Ely-S/Cerebro/spec.txt

Technical Design Document
Cerebral Oximeter
Single-Channel NIRS Relative Oxygenation Monitor
Revision 3.2 - POTS Demonstration System (Prototype 1 Robustness Update)
Course: EE 201 - Biomedical Instrumentation
Application: POTS/Orthostatic Intolerance Demonstration
Precision Target: +/- 2% (Relative Trend)
Safety Criterion: <10mW time-avg emitted power per channel (bench-verified)

-- 1 of 13 --

1. Project Overview
1.1 Objective
Design and build a biomedical device capable of detecting relative changes in cerebral oxygenation through the
human forehead using near-infrared spectroscopy (NIRS). The device is specifically optimized for
demonstrating Postural Orthostatic Tachycardia Syndrome (POTS) and orthostatic intolerance to students.
1.2 Clinical Background
POTS is characterized by an excessive heart rate increase (30+ bpm) within 10 minutes of standing. Clinical
studies show POTS patients experience cerebral oxygen saturation decreases of 5-15% during standing,
compared to only 1-3% in healthy controls. This device enables visualization of these differences for education.
1.3 Project Estimates
Category Time Notes
Probe Assembly 2-3 Hours Including headband fabrication
Circuit Wiring 3-4 Hours Include shielding
Coding & Testing 4-5 Hours Enhanced signal processing
Total Build Time 10-14 Hours Allow extra for troubleshooting
Component Cost: $55-92 USD per station (carrier boards removed per DCN-001)
DCN-002 (2026-03-03): TIA compensation capacitor updated from 4.7pF to 10pF
for robustness. This increases estimated phase margin from ~47deg to ~60deg
against breadboard stray capacitance; not a functional failure correction.

-- 2 of 13 --

2. Design Overview
2.1 How It Works - Simple Explanation
This device measures how much oxygen is in the blood flowing through your brain. It works by shining special
near-infrared light through your forehead and measuring how much light comes back out. Here is the key
principle:
The Basic Idea:
1. Two LEDs shine near-infrared light (730nm and 850nm) into your forehead
2. This light passes through skin, skull, and reaches brain tissue
3. Oxygen-rich blood absorbs different amounts of light than oxygen-poor blood
4. A photodiode detects the light that bounces back
5. By comparing the two wavelengths, we can track oxygenation changes
Think of it like shining a flashlight through your hand in a dark room - you can see the red glow because red
light passes through tissue. Near-infrared light works similarly but penetrates deeper, reaching the brain. Blood
with more oxygen absorbs more infrared light at certain wavelengths, so by measuring how much light is
absorbed, we can track whether brain oxygenation is going up or down.
2.2 Why Two Wavelengths?
We use two different colors of infrared light because oxygenated hemoglobin (HbO2) and deoxygenated
hemoglobin (Hb) absorb light differently at each wavelength:
730nm (Far-Red): More sensitive to deoxygenated blood (Hb)
850nm (Infrared): More sensitive to oxygenated blood (HbO2)
By measuring both, we can track the balance between oxygen delivery and oxygen consumption in brain tissue.
2.3 What the Device Measures
This device measures relative changes from a baseline, not absolute values. It tells you whether oxygenation is
increasing or decreasing compared to when you started measuring. For POTS demonstration:
- When a healthy person stands up, oxygenation may drop 1-3% and quickly recover
- When a POTS patient stands up, oxygenation may drop 5-15% and stay low
- This difference is large enough to clearly see on a real-time graph
2.4 System Block Diagram
+------------------+
| ARDUINO |
| Nano 33 IoT |
| | +------------------+ +------------------+
| D2,D3: LED Ctrl |---->| LED DRIVER |---->| 730nm LED |---+
| | | (TIP31C x2) | | 850nm LED |---|-+
| A4,A5: I2C |<----| | +------------------+ | |
| | +------------------+ | |
| Serial Output | ^ | |
+------------------+ | Light through | |
| | forehead tissue | |
| v | |
| +------------------+ | |
| | PHOTODIODE |<----------------------------+ |
| | (BPW34) |<------------------------------+
| +------------------+

-- 3 of 13 --

| |
| | Tiny electrical current (nano-amps)
| v
| +------------------+
| | AMPLIFIER |
| | (MCP6022) |
| | 2-stage TIA |
| +------------------+
| |
| | Voltage signal (0-3V)
| v
| +------------------+
+------------->| ADC |
| (ADS1115) |
| 16-bit, 64 SPS |
+------------------+
2.5 Complete Wiring Diagram (ASCII)
================================================================================
COMPLETE WIRING DIAGRAM
================================================================================
USB Battery Pack (>=1A, always-on capable)
   |
Arduino USB port (Nano 33 IoT)
   |
  Arduino 5V pin ----> [FUSE 500mA] ----+--> [68R] --> 730nm LED (wire-pigtail, anode->cathode) --> TIP31C Q1 collector
   |                                     |                                                        TIP31C Q1 emitter --> LED_GND_RETURN --> STAR_GND
   |                                     |                                                        D2 --> [470R] --> Q1 base
   |                                     |
   |                                     +--> [68R] --> 850nm LED (wire-pigtail, anode->cathode) --> TIP31C Q2 collector
   |                                                                                                 TIP31C Q2 emitter --> LED_GND_RETURN --> STAR_GND
   |                                                                                                 D3 --> [470R] --> Q2 base
   |
   +--> [150R] --> Green LED --> STAR_GND  (power-on indicator, ~20mA hold load)

Arduino Nano 33 IoT (3.3V logic)
  3.3V ----------------------------------------------+-------------------+
  GND  ---------------------------------------------------------------> STAR_GND
  A4 (SDA) -------------------------------------------> ADS1115 SDA
  A5 (SCL) -------------------------------------------> ADS1115 SCL

ADS1115 ADC
  VDD <-----------------------------------------------+ (3.3V)
  GND <---------------------------------------------------------------- STAR_GND (star node location)
  ADDR ------------------------------------------------> STAR_GND (0x48)
  A0  <----------------------------------------------- MCP6022 OUT2 (Pin 7)

Photodiode + Analog Front End (MCP6022)
  BPW34 cathode --------------------------------------> MCP6022 IN1- (Pin 2)
  BPW34 anode ----------------------------------------> STAR_GND

  Stage 1 TIA:
    Rf = 100k between OUT1 (Pin 1) and IN1- (Pin 2)
    Cf = 10pF in parallel with Rf
    IN1+ (Pin 3) -> STAR_GND
    V+  (Pin 8)  -> 3.3V
    V-  (Pin 4)  -> STAR_GND

  Stage 2 Gain (same MCP6022):
    IN2+ (Pin 5) <- Stage1 OUT (Pin 1)
    IN2- (Pin 6) <- node between Rg=1k to GND and Rf2=47k to OUT2
    OUT2 (Pin 7) -> ADS1115 A0

Decoupling / layout notes:
  - 0.1uF local decoupling at MCP6022 and ADS1115 power pins
  - 100uF bulk cap at Arduino 5V entry node (same node as indicator LED and LED driver fuse)
  - 10uF near analog 3.3V rail
  - BPW34 lead to op-amp kept short (<5cm), shielded
  - Star ground mandatory: LED return uses dedicated LED_GND_RETURN trace; analog grounds return directly to STAR_GND
================================================================================
IMPORTANT NOTES
================================================================================
1. DO NOT connect ADS1115 VDD to 5V - use 3.3V only (Arduino Nano 33 IoT is 3.3V logic)
2. LED power rail comes from Arduino 5V pin through a 500mA fuse
3. Star ground is mandatory: all grounds meet only at STAR_GND near ADS1115 GND
4. LED return current must use a dedicated return trace to STAR_GND (never share analog return path)
5. Photodiode to op-amp wire must be SHORT (< 5cm) and preferably shielded
6. Place 0.1uF decoupling capacitors near MCP6022 and ADS1115 power pins
7. Add bulk rail capacitors: 100uF at Arduino 5V entry and 10uF near analog 3.3V rail
8. Add power-on indicator: Arduino 5V -> 150 Ohm -> Green LED -> STAR_GND
9. The 10pF capacitor across 100k feedback is CRITICAL for stability
RESISTOR VALUES:
- LED current limit (730nm): 68 Ohm, 0.5W
- LED current limit (850nm): 68 Ohm, 0.5W
- Base resistor: 470 Ohm (both transistors)
- TIA feedback: 100k Ohm, metal film 1%
- Stage 2 feedback: 47k Ohm
- Stage 2 ground: 1k Ohm
CAPACITOR VALUES:
- TIA stability: 10pF ceramic (NPO/COG type preferred)
- Power decoupling (local HF): 0.1uF ceramic (x2)
- Bulk decoupling (5V rail entry): 47-100uF electrolytic (x1)
- Bulk decoupling (analog 3.3V rail): 10uF electrolytic or ceramic (x1)
================================================================================

-- 5 of 13 --

3. Technical Specifications
Parameter Specification Notes
Measurement Type Relative Trend Changes from baseline, not absolute
Precision (Relative) Target +/- 2% @ 95% conf Requires bench closure per V&V Test 4.6
Channels 1 (Deep Tissue) 30mm source-detector separation
Wavelengths 730nm & 850nm Industry-standard NIRS wavelengths
Sample Rate ADS1115 64 SPS state rate Conversion-only 4-state TDM gives 16 Hz raw/channel; design-target effective rate is ~15 Hz with required 1ms/state settling delay (bench timing closure required)
Safety Time-avg emitted power < 10mW per channel Bench-measured under final TDM timing and drive settings
4. System Architecture
Stage Function Key Components
1. Emitter High-power NIR LED drive TIP31C, 68 Ohm (730nm) + 68 Ohm (850nm), Cree JE2835AFR / ams OSRAM
2. Detector Photocurrent amplification BPW34, MCP6022 (2-stage TIA)
3. Digital High-resolution sampling ADS1115 @ 64 SPS
4. Processing Signal filtering & output Arduino Nano 33 IoT
5. Optical Probe Tissue interface EVA foam, headband mount
5. Hardware Design Details
5.1 LED Specifications
Component Part Number Specifications
730nm LED Cree JE2835AFR-N-0001A0000-N0000001 Bare SMD 2835 package, ~121 deg beam
850nm LED ams OSRAM SFH4253B 850nm centroid (860nm peak), SMT PLCC-2, 120 deg beam
Alt 850nm Epitex L850-05AU Legacy option if SFH4253B unavailable
5.2 LED Driver Circuit
Each LED is controlled by a TIP31C NPN transistor acting as a switch. The Arduino GPIO (3.3V logic) drives
the transistor base through a 470 Ohm resistor (approximately 5.5mA base current), improving saturation margin
without over-driving the MCU pin. LED current limits are intentionally asymmetric for robustness:
730nm channel uses 68 Ohm (~40mA nominal), 850nm channel uses 68 Ohm (~47mA nominal). This keeps
both channels in the target electrical range while adding optical-safety margin in the 850nm path.
5.3 Two-Stage Transimpedance Amplifier
Stage 1 (TIA): 100k Ohm feedback resistor with 10pF stability capacitor. Converts photodiode current
(nano-amps) to voltage. MCP6022 op-amp chosen for low input bias current and rail-to-rail output.
Stage 2 (Gain): Non-inverting amplifier with 47k/1k = 48x voltage gain.
Total Transimpedance: 100k x 48 = 4.8M Ohm equivalent.

-- 6 of 13 --

5.4 ADS1115 ADC Configuration
Parameter Setting Rationale
PGA Range +/- 2.048V Matches signal range
Sample Rate 64 SPS Lower noise than higher rates
Mode Continuous Smooth data stream
Warning: Connect ADS1115 VDD to 3.3V only (NOT 5V). Arduino Nano 33 IoT uses 3.3V logic levels.

-- 7 of 13 --

6. Bill of Materials
Component Qty Part Number Cost
Arduino Nano 33 IoT 1 ABX00027 $20-25
ADS1115 ADC Module 1 Adafruit 1085 $10-15
MCP6022-I/P Op-Amp 1 DIP-8 $1.50-2
BPW34 Photodiode 1 Vishay $2-4
LED 730nm 1 JE2835AFR-N-0001A0000-N0000001 ~$0.32-2
LED 850nm 1 ams OSRAM SFH4253B $1-4
TIP31C Transistor 2 TO-220 $1-2
Power-On Indicator LED (Green) 1 5mm through-hole ~$0.10
Power-On Indicator Resistor 1 150 Ohm, 1/4W ~$0.05
Elastic Headband 1 2cm wide $3-5
Black EVA Foam 1 2x4x2cm $3-5
USB Battery Pack >=1A, always-on capable 1 Student-provided Excluded from BOM cost
USB Cable for Nano 33 IoT 1 Student-provided Excluded from BOM cost
Electrolytic Capacitor 100uF 1 10V min $0.20-0.50
Capacitor 10uF 1 6.3V min $0.10-0.30
Misc (resistors, caps, wire) set - $5-10
Estimated Total (costed items only): $50-85 USD (student-provided USB power pack + USB cable excluded)
7. Firmware Design for +/-2% Precision
7.1 Key Requirements
To achieve +/-2% precision for POTS demonstration:
1. Exponential Moving Average (EMA) filter with alpha = 0.025 and explicit convention N_eff = 1/alpha = 40
2. 30-second automatic baseline detection
3. Percent change calculation from baseline
4. 4-state TDM sequence (AmbientA -> Red -> AmbientB -> IR) for ambient rejection and optical-duty control
5. 10 Hz output rate for Serial Plotter visualization (decoupled from TDM cycle timing)
6. Enforce 1ms settling delay after each LED GPIO state change before ADC sample acquisition
7.2 TDM Measurement Sequence
Conversion-limited minimum for one full TDM cycle is 62.5ms at ADS1115 64 SPS.
With required 1ms settling delay per state, design-target cycle minimum is 66.5ms:
1. All LEDs OFF - wait 1ms settling - Read ADC - Store as AmbientA
2. Red LED ON - wait 1ms settling - Read ADC - Subtract AmbientA - Store as Red signal
3. All LEDs OFF - wait 1ms settling - Read ADC - Store as AmbientB
4. IR LED ON - wait 1ms settling - Read ADC - Subtract AmbientB - Store as IR signal
5. Apply EMA filter to both channels
6. Calculate percent change from baseline
7. Output to Serial every 100ms (10 Hz display rate)
Notes:
- 62.5ms is the conversion-only lower bound (4 conversions x 15.625ms).
- With 1ms settling delay per state, expected firmware lower bound is 66.5ms.
- Per-channel effective update rate with required settling delay is approximately 15.0 Hz (1 / 0.0665s).
- Actual runtime cycle remains bench-closure dependent and is measured in V&V Test 3.7.
7.3 Core Algorithm
// EMA Filter (alpha=0.025, convention N_eff = 1/alpha = 40)
const float ALPHA = 0.025;
emaRed = ALPHA * redSample + (1 - ALPHA) * emaRed;
emaIR = ALPHA * irSample + (1 - ALPHA) * emaIR;
// Percent Change from Baseline
float pctChangeRed = ((emaRed - baselineRed) / baselineRed) * 100.0;
float pctChangeIR = ((emaIR - baselineIR) / baselineIR) * 100.0;

-- 8 of 13 --

8. Assembly Instructions
8.1 Optical Probe Assembly
Step 1: Cut black EVA foam to 2cm x 4cm x 2cm. Punch one 7mm hole for the photodiode. 30mm away (center-to-center), carve two small adjacent LED pockets sized for bare LED bodies and pigtail routing.
Step 2: Prepare wire-pigtail leads for both LEDs (730nm JE2835AFR and 850nm SFH4253B): pre-tin 30 AWG wires, solder one lead per pad, and add short heat-shrink for strain relief.
Step 3: Superglue a stack of 2-3 black rubber washers (1/8" / 3mm Inner Diameter) directly over the 730nm LED dome, then insert both pigtailed LEDs into foam pockets with emitting surfaces flush to the tissue-contact side. Secure with opaque adhesive and label each LED wire.
Step 4: Insert BPW34 photodiode into Hole 2 with lens facing tissue side (flat side = cathode, facing away). Use
shielded wire for connection.
Step 5 - CRITICAL: Wrap additional black foam or tape around LED and photodiode housings. The rubber washer stack on the 730nm LED MUST be perfectly seated. Light MUST
NOT pass directly from LED to photodiode through foam. This is the #1 failure point.
Step 6: Attach foam block to center of elastic headband. Add soft padding around edges for comfort.
Step 7 - Verify: Point probe into dark space. Signal should be near zero. Any significant reading indicates light
leak.
Critical Warning: Direct LED-to-photodiode light paths will overwhelm the tissue signal. Take extra time to
verify complete optical isolation before proceeding.
8.2 Circuit Assembly Notes
Power Rails:
- 5V rail (Arduino 5V pin via USB battery input): LED driver circuit + power-on indicator
- 3.3V rail (Arduino pin): Op-amp V+, ADS1115 VDD
- Star ground: single node at/near ADS1115 GND; LED return must be separate from analog returns
Wire Guidelines:
- Photodiode to op-amp: Maximum 5cm, use shielded cable
- Keep analog and digital signals separated
- Add 0.1uF decoupling capacitors at MCP6022 and ADS1115 power pins
- Add 100uF bulk capacitor at Arduino 5V entry and 10uF near analog 3.3V rail
- Add power-on indicator at 5V entry node: 150 Ohm + green LED to star ground
9. Calibration and Validation
9.1 Pre-Use Tests
Test 1 - Dark Reading: Cover probe completely with opaque material. Signal should be near zero (+/- 5%).
Test 2 - Light Response: Point probe at room light. Signal should increase significantly.
Test 3 - Finger Test: Place finger over probe. Should see strong signal (blood absorbs light).
Test 4 - Baseline Stability: Subject supine for 30 sec. Signal should be stable within +/- 3%.
9.2 Before Each Demonstration
1. Apply probe to subject forehead with consistent pressure
2. Subject lies supine for 2 minutes (stabilization)
3. Wait for 'Baseline established' message

-- 9 of 13 --

4. Verify signal stability over 30 seconds before starting test

-- 10 of 13 --

10. POTS/Orthostatic Intolerance Demonstration Protocol
10.1 Equipment Required
- Cerebral oximeter device (assembled and calibrated)
- Examination table or tilt table
- Pulse oximeter for simultaneous HR monitoring
- Computer with Arduino Serial Plotter
- Chair for subject safety during recovery
10.2 Subject Preparation
1. Explain procedure and obtain informed consent
2. Subject avoids caffeine, large meals, exercise for 2 hours prior
3. Clean forehead with alcohol swab (remove oils for better contact)
4. Apply headband with probe over left forehead (avoid hairline)
5. Adjust for snug but comfortable fit
10.3 Supine-to-Stand Test Protocol
Phase Duration Activity Expected Response
1. Rest 2 min Subject supine Signal stabilizes
2. Baseline 3 min Continue supine Stable SctO2, HR 60-80
3. Transition 15 sec Stand quickly Brief dip, partial recovery
4. Standing 5-10 min Stand still See interpretation table
5. Recovery 3 min Return supine SctO2 returns to baseline
10.4 Expected Results by Subject Type
Parameter Healthy Control POTS Patient Vasovagal
HR Change +10-20 bpm +30-50+ bpm +20-40 bpm
Peak HR <100 bpm >120 bpm Variable
SctO2 Change -1 to -3% -5 to -15% -10 to -20%
Pattern Quick adaptation Sustained drop Progressive decline
Recovery <30 sec 1-3 min Variable
10.5 Real-Time Interpretation for Students
Normal Response:
Heart rate increases 10-20 bpm to compensate for gravity. Blood vessels in legs constrict to push blood upward.
Cerebral oxygenation drops only 1-3% - the brain remains well-oxygenated. Body quickly adapts and maintains
stable perfusion.
POTS Response:
Excessive heart rate increase (30+ bpm) indicates inadequate vasoconstriction. Blood pools in lower extremities

-- 11 of 13 --

despite rapid heart rate. Cerebral oxygenation drops 5-15% - the brain is becoming hypoperfused. Patient
experiences lightheadedness and palpitations. Recovery is slower because the autonomic system struggles to
re-adapt.
10.6 Safety Guidelines
Stop the test immediately if:
- Subject feels faint or vision blurs
- Subject appears pale, sweaty, or confused
- SctO2 drops more than 20% from baseline
- Heart rate exceeds 150 bpm
- Subject requests to stop
Recovery procedure: Help subject lie down immediately, elevate legs if possible, monitor until symptoms
resolve.
IMPORTANT: This is for educational demonstration only. It is NOT a diagnostic test for POTS. Clinical POTS
diagnosis requires comprehensive autonomic testing by qualified medical professionals.

-- 12 of 13 --

11. Expected Results and Interpretation
Signal Change Physiological Meaning Clinical Significance
0 to -2% Normal adaptation Healthy response
-2 to -5% Mild hypoperfusion May be normal or mild OI
-5 to -10% Moderate hypoperfusion Suggests orthostatic intolerance
-10 to -15% Significant hypoperfusion Consistent with POTS/VVS
>-15% Severe hypoperfusion High syncope risk
Teaching Points: This demonstration teaches autonomic physiology, baroreceptor reflex, cerebral
autoregulation, POTS pathophysiology, NIRS technology, and signal processing principles.
12. Design Assumptions
Category Assumption Rationale
Physiological NIR penetrates skull to cortex Optical window 650-950nm
Physiological POTS causes 5-15% SctO2 drop Clinical studies confirm
Technical EMA convention fixed to N_eff = 1/alpha = 40 Ensures consistent filter interpretation across docs/tests
Technical Two-stage TIA optimal Better noise performance
Safety Criterion basis is explicit and bench-verifiable Time-avg emitted power per channel < 10mW in final TDM mode
13. Limitations
Device: Relative measurements only, single-channel, forehead only, subject variability.
Confounding: Extracranial contamination, motion artifact, ambient light, probe contact variations.
Safety: Not FDA evaluated, not for clinical diagnosis, educational use only.
14. References
1. Novak P. 'Cerebral Blood Flow in Orthostatic Intolerance.' JAHA. 2025.
2. Novak V et al. 'Cerebral oximetry in POTS patients.' Clin Auton Res. 2019.
3. Schie H et al. 'Cerebral oxygenation responses to postural changes.' Eur J Appl Physiol. 2019.
4. ISO 9919:2005. 'Pulse oximeter equipment.'
5. IEC 60825-1:2014. 'Safety of laser products.'
6. TI SBOA055. 'Compensate Transimpedance Amplifiers.'
7. Vishay BPW34 Datasheet.

-- 13 of 13 --
