Ely-S/Cerebro/BOM.txt

Complete Bill of Materials (BOM)
Project: Cerebral Oximeter (Prototype 1)
Aligned documents: spec.txt Rev 3.2, validation_and_verification_plan.txt Rev 3.2
Build quantity: 1 unit
Date: 2026-03-02

Notes:
- Prices are indicative and vary by distributor/region.
- For components with no public per-part datasheet page, vendor request links are provided.
- Qty includes only assembly parts (not lab instruments/tools).
- DCN-001 (2026-03-02): Item #6 updated to Cree JE2835AFR and LED carrier boards removed from the build.
- DCN-002 (2026-03-03): Item #14 updated from FG18C0G1H4R7CNT00 (4.7pF) to FG18C0G1H100DNT00 (10pF). Robustness update: estimated TIA phase margin increases from ~47deg to ~60deg against breadboard stray capacitance; not a functional failure correction.

================================================================================
1) Core Electronics
================================================================================

1. MCU Board
   Qty: 1
   MPN: ABX00027
   Description: Arduino Nano 33 IoT
   Product page: https://docs.arduino.cc/hardware/nano-33-iot
   Datasheet: https://docs.arduino.cc/resources/datasheets/ABX00027-datasheet.pdf

2. External ADC Module
   Qty: 1
   MPN: Adafruit 1085 (ADS1115 breakout)
   Description: 16-bit I2C ADC board
   Product page: https://www.adafruit.com/product/1085
   Distributor search (Digi-Key): https://www.digikey.com/en/products/result?s=adafruit%201085
   Distributor search (Mouser): https://www.mouser.com/c/?q=Adafruit%201085
   Datasheet (ADC IC): https://www.ti.com/lit/ds/symlink/ads1115.pdf

3. Dual Op-Amp
   Qty: 1
   MPN: MCP6022-I/P
   Description: Rail-to-rail dual op-amp, DIP-8
   Product page: https://www.microchip.com/en-us/product/MCP6022
   Datasheet: https://ww1.microchip.com/downloads/en/DeviceDoc/20001685E.pdf

4. Photodiode
   Qty: 1
   MPN: BPW34
   Description: Silicon PIN photodiode
   Product page: https://www.vishay.com/en/product/81521/
   Datasheet: https://www.vishay.com/docs/81521/bpw34.pdf

5. NPN LED Driver Transistor
   Qty: 2
   MPN: TIP31C
   Description: NPN power transistor, TO-220
   Product page: https://www.st.com/en/power-transistors/tip31c.html
   Datasheet: https://www.st.com/resource/en/datasheet/tip31c.pdf

6. 730nm Source LED (per DCN-001 primary)
   Qty: 1
   MPN: JE2835AFR-N-0001A0000-N0000001
   Description: 730nm far-red emitter, Cree LED J Series 2835, 2-pad bottom-contact SMD
   Product page: https://www.digikey.com/en/products/detail/cree-led/JE2835AFR-N-0001A0000-N0000001/16678464
   DigiKey Part Number: 2138-JE2835AFR-N-0001A0000-N0000001CT-ND
   Datasheet: https://downloads.cree-led.com/files/ds/j/JSeries-2835-Color.pdf

7. 850nm Source LED (per spec primary)
   Qty: 1
   MPN: SFH4253B
   Description: 850nm centroid (860nm peak) IR emitter, SMT PLCC-2, 120 deg beam
   Product page: https://ams-osram.com/products/leds/ir-leds/osram-topled-sfh-4253b
   Datasheet: https://look.ams-osram.com/m/631defe919332729/original/SFH-4253B.pdf

================================================================================
2) Resistors
================================================================================

8. LED current resistor (730nm channel)
   Qty: 1
   MPN: CFR-50JB-52-68R
   Description: 68 ohm, 0.5W, axial
   Product page: https://www.mouser.com/ProductDetail/YAGEO/CFR-50JB-52-68R
   Datasheet (series): https://www.mouser.com/datasheet/2/447/YAGEO_CFR_datasheet_2023v2-3388672.pdf

9. LED current resistor (850nm channel)
   Qty: 1
   MPN: CFR-50JB-52-68R
   Description: 68 ohm, 0.5W, axial
   Product page: https://www.mouser.com/ProductDetail/YAGEO/CFR-50JB-52-68R
   Datasheet (series): https://www.mouser.com/datasheet/2/447/YAGEO_CFR_datasheet_2023v2-3388672.pdf

10. Transistor base resistor
    Qty: 2
    MPN: CFR-50JB-52-470R
    Description: 470 ohm, 0.5W, axial
    Product page: https://www.mouser.com/ProductDetail/YAGEO/CFR-50JB-52-470R
    Datasheet (series): https://www.mouser.com/datasheet/2/447/YAGEO_CFR_datasheet_2023v2-3388672.pdf

11. TIA feedback resistor
    Qty: 1
    MPN: MFR-25FBF52-100K
    Description: 100 kohm, 1%, metal film
    Product page: https://www.mouser.com/ProductDetail/YAGEO/MFR-25FBF52-100K
    Datasheet (series): https://www.mouser.com/datasheet/2/447/YAGEO_MFR_datasheet_2021v1-3003041.pdf

12. Stage-2 feedback resistor
    Qty: 1
    MPN: MFR-25FBF52-47K
    Description: 47 kohm, 1%, metal film
    Product page: https://www.mouser.com/ProductDetail/YAGEO/MFR-25FBF52-47K
    Datasheet (series): https://www.mouser.com/datasheet/2/447/YAGEO_MFR_datasheet_2021v1-3003041.pdf

13. Stage-2 gain set resistor
    Qty: 1
    MPN: MFR-25FBF52-1K
    Description: 1 kohm, 1%, metal film
    Product page: https://www.mouser.com/ProductDetail/YAGEO/MFR-25FBF52-1K
    Datasheet (series): https://www.mouser.com/datasheet/2/447/YAGEO_MFR_datasheet_2021v1-3003041.pdf

================================================================================
3) Capacitors
================================================================================

14. TIA compensation capacitor
    Qty: 1
    MPN: FG18C0G1H100DNT00
    Description: 10pF, C0G/NP0, radial ceramic, 50V
    Product page: https://www.mouser.com/ProductDetail/TDK/FG18C0G1H100DNT00
    Datasheet (series): https://product.tdk.com/system/files/dam/doc/product/capacitor/ceramic/lead-mlcc/catalog/fg_e.pdf

15. Local high-frequency decoupling capacitors
    Qty: 2
    MPN: C315C104K5R5TA7301
    Description: 0.1uF, radial ceramic
    Product page: https://www.mouser.com/ProductDetail/KEMET/C315C104K5R5TA
    Datasheet (series): https://content.kemet.com/datasheets/KEM_C1006_X7R.pdf

16. 5V rail bulk capacitor
    Qty: 1
    MPN: EEU-FR1A101B
    Description: 100uF, 10V, low-ESR electrolytic (use 47uF-100uF range)
    Product page: https://www.mouser.com/ProductDetail/Panasonic/EEU-FR1A101B
    Datasheet (series): https://na.industrial.panasonic.com/products/capacitors/aluminum-electrolytic-capacitors/lineup/aluminum-electrolytic-capacitors-radial-lead-type/series/83367

17. Analog 3.3V rail bulk capacitor
    Qty: 1
    MPN: ECE-A1VKS100B
    Description: 10uF, 35V, radial electrolytic (KS Series)
    Product page: https://www.mouser.com/ProductDetail/Panasonic/ECE-A1VKS100B
    Datasheet (series): https://na.industrial.panasonic.com/products/capacitors/aluminum-electrolytic-capacitors/series/83982

================================================================================
4) Protection and Power
================================================================================

18. LED rail fuse (Arduino 5V branch)
    Qty: 1
    MPN: 0215.500MXP
    Description: 500mA, 5x20mm, slow-blow ceramic fuse
    Product page: https://littelfusesales.com/Products/Single/0215.500MXP
    Datasheet: https://www.littelfuse.com/~/media/electronics/datasheets/fuses/littelfuse_fuse_215_datasheet.pdf

19. USB battery pack (student-provided)
    Qty: 1
    MPN: Generic USB battery pack, >=1A, always-on/low-current capable
    Description: USB power bank used to power Arduino USB input
    Product page: N/A (student-provided)
    Datasheet: N/A (student-provided)

20. Power-on indicator LED
    Qty: 1
    MPN: Generic 5mm green LED
    Description: Visible power indicator and auto-shutoff mitigation load
    Product page: Generic through-hole 5mm green LED from distributor stock
    Datasheet: Vendor-specific (generic part acceptable)

21. Power-on indicator resistor
    Qty: 1
    MPN: 150 Ohm, 1/4W axial resistor (generic)
    Description: Series resistor for 5V power-on LED indicator
    Product page: Generic 150 Ohm resistor from resistor assortment or distributor stock
    Datasheet: Vendor-specific (generic part acceptable)

================================================================================
5) Mechanical and Integration Materials
================================================================================

22. Elastic headband (2cm width)
    Qty: 1
    MPN: Generic non-conductive elastic headband, 20mm width
    Product page: https://www.mcmaster.com/elastic-straps/
    Datasheet: N/A (consumer/mechanical textile item)

23. Black EVA foam block/sheet
    Qty: 1
    MPN: Generic black EVA foam (cut to probe dimensions)
    Product page: https://www.mcmaster.com/foam/
    Datasheet: N/A (consumer/mechanical foam item)

24. Shielded cable for photodiode lead
    Qty: 1 length (<= 5cm in final assembly)
    MPN: 30 AWG shielded cable, single-pair or miniature coax
    Product page: https://www.mcmaster.com/shielded-cable/
    Datasheet: vendor-specific (depends on selected cable)

25. Opaque adhesive/tape for optical isolation
    Qty: 1 roll
    MPN: 3M Super 33+ (or equivalent opaque electrical tape)
    Product page: N/A (student-provided)
    Datasheet: N/A (student-provided)

26. Breadboard/perfboard + hookup wire
    Qty: 1 set
    MPN: Standard 2.54mm prototyping supplies
    Product page: N/A (student-provided)
    Datasheet: N/A (student-provided)

27. USB cable (for Nano 33 IoT to host, student-provided)
    Qty: 1
    MPN: USB data cable compatible with Nano 33 IoT connector
    Product page: N/A (student-provided)
    Datasheet: N/A (student-provided)

28. Black Rubber Washers (Optical Baffle)
    Qty: 1 small pack (only 2-3 needed per build)
    MPN: Generic #4 or M3 flat black rubber washer (~1/8" ID)
    Product page: Any hardware store or generic supply
    Datasheet: N/A (mechanical item)

================================================================================
BOM Summary (1 build)
================================================================================

- Core electronics and passives: typically ~USD 50-85 depending LED sourcing (carrier boards removed per DCN-001, wall adapter removed, indicator parts added).
- Availability note: 730nm (Cree JE2835AFR-N-0001A0000-N0000001) and 850nm (ams OSRAM SFH4253B) emitters remain widely available from major distributors.
- Student-provided items excluded from costed BOM: USB battery pack and USB cable.
- Before ordering, run one final check against local stock and lead times.
