Ely-S/Cerebro/BOM.csv

Item # | Category | Item | Qty | Original MPN | Manufacturer/Brand | Octopart MPN to Order | Match Type | Octopart Link | Mouser Link | Mouser Part Number | Notes
1 | Core Electronics | MCU Board | 1 | ABX00027 | Arduino | ABX00027 | Search Needed | https://octopart.com/search?q=ABX00027 | https://www.mouser.com/new/arduino/arduino-nano-33-iot/ | ABX00027 | No clean indexed Octopart product page found; verify exact board listing before order.
2 | Core Electronics | External ADC Module | 1 | Adafruit 1085 (ADS1115 breakout) | Adafruit | Adafruit 1085 (ADS1115 breakout) | Exact | https://octopart.com/search?q=Adafruit%201085 | https://www.mouser.com/c/?q=Adafruit%201085 | Adafruit 1085 | Keep module form factor to satisfy External ADC Module requirement; order from Digi-Key/Mouser search results based on stock.
3 | Core Electronics | Dual Op-Amp | 1 | MCP6022-I/P | Microchip | MCP6022-I/P | Exact | https://octopart.com/mcp6022-i%2Fp-microchip-419146 | https://www.mouser.com/c/?q=MCP6022-I%2FP | MCP6022-I/P | Direct Octopart listing found.
4 | Core Electronics | Photodiode | 1 | BPW34 | Vishay | VBPW34S | Replacement | https://octopart.com/vbpw34s-vishay-42877871 | https://www.mouser.com/ProductDetail/782-BPW34 | 782-BPW34 | Exact Mouser listing selected for BPW34.
5 | Core Electronics | NPN LED Driver Transistor | 2 | TIP31C | STMicroelectronics | TIP31C | Exact | https://octopart.com/tip31c-stmicroelectronics-15555 | https://www.mouser.com/c/?q=TIP31C | TIP31C | STMicroelectronics TIP31C selected as the project-standard source.
6 | Core Electronics | 730nm Source LED (per DCN-001 primary) | 1 | JE2835AFR-N-0001A0000-N0000001 | Cree LED | JE2835AFR-N-0001A0000-N0000001 | Exact | https://octopart.com/search?q=JE2835AFR-N-0001A0000-N0000001 | https://www.digikey.com/en/products/detail/cree-led/JE2835AFR-N-0001A0000-N0000001/16678464 | 2138-JE2835AFR-N-0001A0000-N0000001CT-ND | Bare SMD 2835 package; wire-pigtail mounting per DCN-001; retain rubber washer baffle for optical isolation.
7 | Core Electronics | 850nm Source LED (per spec primary) | 1 | SFH4253B | ams OSRAM | SFH4253B | Exact | https://octopart.com/search?q=SFH4253B | https://ams-osram.com/products/leds/ir-leds/osram-topled-sfh-4253b | SFH4253B | Commonly stocked 850nm emitter (SMT PLCC-2, 120 deg beam). Use wire-pigtail mounting and revalidate drive current under final build as part of V&V.
8 | Resistors | LED current resistor (730nm channel) | 1 | CFR-50JB-52-68R | YAGEO | CFR-50JB-52-68R | Search Needed | https://octopart.com/search?q=CFR-50JB-52-68R | https://www.mouser.com/ProductDetail/YAGEO/CFR-50JB-52-68R | CFR-50JB-52-68R | Value changed to 68 Ohms to safely drive the high-power 730nm LED. Optional prototype kit source: https://www.amazon.com/ALLECIN-Values-Resistor-Resistors-Assortment/dp/B0BTP63DGQ/
9 | Resistors | LED current resistor (850nm channel) | 1 | CFR-50JB-52-68R | YAGEO | CFR-50JB-52-68R | Search Needed | https://octopart.com/search?q=CFR-50JB-52-68R | https://www.mouser.com/ProductDetail/YAGEO/CFR-50JB-52-68R | CFR-50JB-52-68R | Value changed to 68 Ohms to resolve safety violation ISSUE-002. Optional prototype kit source: https://www.amazon.com/ALLECIN-Values-Resistor-Resistors-Assortment/dp/B0BTP63DGQ/
10 | Resistors | Transistor base resistor | 2 | CFR-50JB-52-470R | YAGEO | CFR-50JB-52-470R | Search Needed | https://octopart.com/search?q=CFR-50JB-52-470R | https://www.mouser.com/ProductDetail/YAGEO/CFR-50JB-52-470R | CFR-50JB-52-470R | Series appears on Octopart but exact value not cleanly indexed in search results. Optional prototype kit source: https://www.amazon.com/ALLECIN-Values-Resistor-Resistors-Assortment/dp/B0BTP63DGQ/
11 | Resistors | TIA feedback resistor | 1 | MFR-25FBF52-100K | YAGEO | MFR-25FBF52-100K | Search Needed | https://octopart.com/search?q=MFR-25FBF52-100K | https://www.mouser.com/ProductDetail/YAGEO/MFR-25FBF52-100K | MFR-25FBF52-100K | Family is listed; use matrix/search page to select exact resistance. Optional prototype kit source: https://www.amazon.com/ALLECIN-Values-Resistor-Resistors-Assortment/dp/B0BTP63DGQ/
12 | Resistors | Stage-2 feedback resistor | 1 | MFR-25FBF52-47K | YAGEO | MFR-25FBF52-47K | Search Needed | https://octopart.com/search?q=MFR-25FBF52-47K | https://www.mouser.com/ProductDetail/YAGEO/MFR-25FBF52-47K | MFR-25FBF52-47K | Family is listed; use matrix/search page to select exact resistance. Optional prototype kit source: https://www.amazon.com/ALLECIN-Values-Resistor-Resistors-Assortment/dp/B0BTP63DGQ/
13 | Resistors | Stage-2 gain set resistor | 1 | MFR-25FBF52-1K | YAGEO | MFR-25FBF52-1K | Exact | https://octopart.com/datasheet/mfr-25fbf52-1k-yageo-18902051 | https://www.mouser.com/ProductDetail/YAGEO/MFR-25FBF52-1K | MFR-25FBF52-1K | Exact MPN indexed via Octopart datasheet entry. Optional prototype kit source: https://www.amazon.com/ALLECIN-Values-Resistor-Resistors-Assortment/dp/B0BTP63DGQ/
14 | Capacitors | TIA compensation capacitor | 1 | FG18C0G1H100DNT00 | TDK | FG18C0G1H100DNT00 | Exact | https://octopart.com/search?q=FG18C0G1H100DNT00 | https://www.mouser.com/c/?q=FG18C0G1H100DNT00 | 810-FG18C0G1H100DNT0 | DCN-002: Value increased from 4.7pF to 10pF (C0G 50V radial) to improve TIA phase margin robustness (~47deg to ~60deg) against breadboard stray capacitance; verify availability and keep an alternate qualified.
15 | Capacitors | Local high-frequency decoupling capacitors | 2 | C315C104K5R5TA7301 | KEMET | C315C104K5R5TA7301 | Search Needed | https://octopart.com/search?q=C315C104K5R5TA7301 | https://www.mouser.com/ProductDetail/KEMET/C315C104K5R5TA | C315C104K5R5TA | Fixed from Z5U to X7R dielectric.
16 | Capacitors | 5V rail bulk capacitor | 1 | EEU-FR1A101B | Panasonic | EEUFR1H101 | Replacement | https://octopart.com/eeufr1h101-panasonic-13148190 | https://www.mouser.com/ProductDetail/Panasonic/EEU-FR1A101B | EEU-FR1A101B | 100uF FR-series substitute found with higher voltage class.
17 | Capacitors | Analog 3.3V rail bulk capacitor | 1 | ECE-A1VKS100B | Panasonic | ECE-A1VKS100B | Exact | https://octopart.com/search?q=ECE-A1VKS100B | https://www.mouser.com/ProductDetail/Panasonic/ECE-A1VKS100B | ECE-A1VKS100B | Panasonic 10uF 35V electrolytic; meets 10uF and >=6.3V spec for analog 3.3V bulk decoupling.
18 | Protection and Power | LED rail fuse (Arduino 5V branch) | 1 | 0215.500MXP | Littelfuse | 0215.500MXP | Search Needed | https://octopart.com/search?q=0215.500MXP | https://www.mouser.com/c/?q=0215.500MXP | 0215.500MXP | Exact 500mA 5x20 slow-blow listing not returned in web indexing; verify in Octopart with param filters.
19 | Protection and Power | USB battery pack (student-provided) | 1 | Generic USB battery pack >=1A, always-on capable | Generic |  | Student Provided |  |  |  | Required to power Arduino over USB; provided by student and excluded from costed BOM.
20 | Protection and Power | Power-on indicator LED | 1 | Generic 5mm green LED | Generic |  | Search Needed |  |  |  | Green LED from Arduino 5V to STAR_GND for power indication and battery auto-shutoff mitigation.
21 | Resistors | Power-on indicator resistor | 1 | 150 Ohm, 1/4W axial resistor | Generic |  | Search Needed |  |  |  | Series resistor for new 5V power-on indicator LED.
22 | Mechanical and Integration Materials | Elastic headband (2cm width) | 1 | Generic non-conductive elastic headband, 20mm width | Generic | 3339913 (RS Pro APLIX 800 strap family) | Replacement | https://octopart.com/search?q=3339913 |  |  | Hook-and-loop strap replacement from Octopart ecosystem; confirm comfort/fit for wearable use.
23 | Mechanical and Integration Materials | Black EVA foam block/sheet | 1 | Generic black EVA foam | Generic | 6191786 | Replacement | https://octopart.com/6191786-rs+pro-76762896 |  |  | Adhesive black EPDM foam tape replacement.
24 | Mechanical and Integration Materials | Shielded cable for photodiode lead | 1 length (<= 5cm) | 30 AWG shielded cable, single-pair or miniature coax | Generic | C1156.41.01 | Replacement | https://octopart.com/c1156.41.01-general+cable+%2F+carol-47574872 | https://www.mouser.com/c/wire-cable/coaxial-cables/?rg+type=RG-174%2FU | RG-174/U | RG174-class shielded coax replacement.
25 | Mechanical and Integration Materials | Opaque adhesive/tape for optical isolation | 1 roll | 3M Super 33+ (or equivalent opaque electrical tape) | 3M | 3M Super 33+ | Search Needed | https://octopart.com/search?q=3M%20Super%2033%2B | https://www.3m.com/3M/en_US/p/d/v000057514/ |  | 3M Super 33+ opaque electrical tape for optical isolation and light blocking.
26 | Mechanical and Integration Materials | Breadboard/perfboard + hookup wire | 1 set | Standard 2.54mm prototyping supplies | Generic |  | Search Needed |  | https://www.adafruit.com/category/84 |  | Tooling/materials set for prototyping and assembly wiring.
27 | Mechanical and Integration Materials | USB cable (for Nano 33 IoT to host, student-provided) | 1 | USB data cable compatible with Nano 33 IoT connector | Generic |  | Student Provided |  |  |  | Cable is provided by student and excluded from costed BOM.
28 | Mechanical and Integration Materials | Black Rubber Washers (Optical Baffle) | 1 small pack (2-3 used per build) | Generic #4 or M3 flat black rubber washer (~1/8 inch ID) | Generic |  | Search Needed |  |  |  | Mechanical item used to restrict 730nm LED beam angle for optical isolation.
