Ely-S/Cerebro/hardware-validation.txt

# Hardware Component Verification
Project: Cerebral Oximeter (Prototype 1)  
Date: 2026-03-03  
Basis: `spec.txt` Rev 3.2, `BOM.txt`, `validation.txt`, `validation_and_verification_plan.txt` Rev 3.2
DCN-002 (2026-03-03): Item #14 updated from FG18C0G1H4R7CNT00 (4.7pF) to
FG18C0G1H100CNT00 (10pF). Robustness update: estimated TIA phase margin
increases from ~47deg to ~60deg against breadboard stray capacitance; not a
functional failure correction.
Affected files: `hardware-validation.txt`, `BOM.txt`, `vv_calculations.md`.

## 1) Purpose
This document records hardware component-level verification using datasheets and authoritative online sources.  
It complements (does not replace) bench verification requirements in `validation.txt`.

## 2) Status Labels
- VERIFIED: Component choice is supported by source specs and is compatible with design intent.
- PARTIAL: Usable source exists, but source is secondary/non-manufacturer or incomplete for exact MPN.
- BENCH-REQUIRED: Datasheet compatibility is acceptable, but requirement closure depends on bench testing.
- N/A: Mechanical/tooling item with no formal electrical datasheet requirement.

## 2A) Source Documentation
- Optics source provenance is centralized in `datasheets/optics_source_register.txt`.
- Numeric optics decisions prioritize manufacturer datasheets over product-page summaries or mirrors.
- Any optics claim without direct primary citation is marked unverified/pending.

## 3) Verification Matrix

### Core electronics
1. Arduino Nano 33 IoT (`ABX00027`)  
   Status: VERIFIED, BENCH-REQUIRED  
   Evidence:
   - https://docs.arduino.cc/resources/datasheets/ABX00027-datasheet.pdf  
   Notes:
   - Board I/O is 3.3 V only and not 5 V tolerant, matching design rail assumptions.

2. ADS1115 ADC (`Adafruit 1085` uses ADS1115 IC)  
   Status: VERIFIED, BENCH-REQUIRED  
   Evidence:
   - https://www.ti.com/lit/ds/symlink/ads1115.pdf  
   Notes:
   - Supply range and operating modes support intended 3.3 V operation and 64 SPS setting.

3. MCP6022-I/P op-amp  
   Status: VERIFIED, BENCH-REQUIRED  
   Evidence:
   - https://ww1.microchip.com/downloads/en/DeviceDoc/20001685E.pdf  
   Notes:
   - Supply range and amplifier characteristics are compatible with two-stage TIA/gain architecture.

4. BPW34 photodiode  
   Status: VERIFIED, BENCH-REQUIRED  
   Evidence:
   - https://www.vishay.com/docs/81521/bpw34.pdf  
   Notes:
   - Spectral sensitivity includes 730 nm and 850 nm region used by design.

5. TIP31C transistor  
   Status: VERIFIED, BENCH-REQUIRED  
   Evidence:
   - https://www.st.com/resource/en/datasheet/tip31c.pdf  
   Notes:
   - Electrical limits are appropriate for low-side LED switching in this design.

6. 730 nm LED (`Cree JE2835AFR-N-0001A0000-N0000001` bare SMD)  
   Status: VERIFIED, BENCH-REQUIRED  
   Evidence:
   - https://downloads.cree-led.com/files/ds/j/JSeries-2835-Color.pdf  
   Notes:
   - Test-current electrical point: V_F typ 2.15V at 140mA.
   - Optical estimate reference: 128mW typ radiant flux at 140mA.
   - Part uses 2-pad 2835 package and supports wire-pigtail mounting with washer baffle for optical isolation.

7. 850 nm LED (`ams OSRAM SFH4253B`)  
   Status: VERIFIED, BENCH-REQUIRED  
   Evidence:
   - datasheets/optics_sfh4253b_datasheet.pdf (ams-OSRAM, Version 1.2, 2025-12-01)
   - https://look.ams-osram.com/m/631defe919332729/original/SFH-4253B.pdf
   - https://ams-osram.com/products/leds/ir-leds/osram-topled-sfh-4253b  
   Confirmed datasheet values:
   - Centroid wavelength: 850nm; peak wavelength: 860nm
   - Half angle: 60deg (full beam angle: 120deg)
   - IF max: 100mA continuous
   - VF min/typ/max at 70mA: 1.15V / 1.55V / 1.90V; VF typ at 100mA: 1.60V
   - Total radiant flux: 55mW typ at 70mA; 80mW typ at 100mA
   Notes:
   - Package is SMT PLCC-2 (120deg beam); probe build uses wire-pigtail mounting in DCN-001.
   - IEC 62471 status is currently unverified in the cited SFH4253B PDF text extraction; add a direct manufacturer citation before claiming a specific risk group.
   - [ISSUE-002, RESOLVED] Optical safety: Original design had 850nm current at ~89mA resulting in time-averaged power exceeding 10mW. Resistor changed from 36 Ohms to 68 Ohms. New current ~47mA, peak flux ~36-40mW, and average power ~9-10mW (bench verification still required for strict <10mW closure).
   - [ISSUE-003, MINOR] VF used in current calculation corrected from 1.5V to 1.60V (datasheet
     explicit at 100mA). Corrected current with 68 Ohms: 47.1mA -- within the 40-50mA band. See validation.txt.

### Resistors
8-10. CFR series (`68R`, `68R`, `470R`)  
Status: VERIFIED, BENCH-REQUIRED  
Evidence:
- https://www.yageogroup.com/content/Resource%20Library/Datasheet/YAGEO-CFR_DATASHEET.pdf  
Notes:
- Power/tolerance family supports selected current-limit and base-drive roles.

11-13. MFR series (`100k`, `47k`, `1k`)  
Status: VERIFIED, BENCH-REQUIRED  
Evidence:
- https://www.yageogroup.com/content/Resource%20Library/Datasheet/YAGEO-MFR_DATASHEET.pdf  
Notes:
- 1% metal-film family selection is appropriate for gain-setting and TIA feedback.

### Capacitors
14. `FG18C0G1H100CNT00` (10 pF C0G)  
Status: VERIFIED, BENCH-REQUIRED  
Evidence:
- https://product.tdk.com/system/files/dam/doc/product/capacitor/ceramic/lead-mlcc/catalog/fg_e.pdf  
- https://octopart.com/part/tdk/FG18C0G1H100CNT00  
Notes:
- C0G Class I stability supports compensation role in TIA stage.
- Value increased from 4.7pF to 10pF (DCN-002) to improve estimated phase
  margin from ~47deg to ~60deg against breadboard stray capacitance.
- Verify availability before ordering; any C0G/NP0 10pF radial 50V+ part is
  an acceptable alternate.

15. `C315C104K5R5TA7301` (0.1 uF local decoupling)  
   Status: VERIFIED, BENCH-REQUIRED  
   Evidence:
   - https://content.kemet.com/datasheets/KEM_C1006_X7R.pdf  
   Notes:
   - X7R radial ceramic family is appropriate for local high-frequency bypass function.

16. `EEU-FR1A101B` (100 uF, 10 V)  
Status: VERIFIED, BENCH-REQUIRED  
Evidence:
- https://na.industrial.panasonic.com/products/capacitors/aluminum-electrolytic-capacitors/lineup/aluminum-electrolytic-capacitors-radial-lead-type/series/83367  
Notes:
- FR series supports low-ESR bulk filtering role; voltage and temperature class are appropriate.

17. `ECE-A1VKS100B` (10 uF, 35 V)  
Status: VERIFIED, BENCH-REQUIRED  
Evidence:
- https://octopart.com/part/panasonic/ECE-A1VKS100B  
- https://na.industrial.panasonic.com/products/capacitors/aluminum-electrolytic-capacitors/series/83982  
Notes:
- Series-level confirmation supports suitability for low-voltage bulk decoupling role.

### Protection and power
18. `0215.500MXP` fuse  
Status: VERIFIED, BENCH-REQUIRED  
Evidence:
- https://www.littelfuse.com/assetdocs/fuse-215-datasheet?assetguid=990f7193-d9a2-48e4-b760-2b43514249cf  
Notes:
- 5x20 mm time-lag ceramic family and 500 mA class match design protection intent.

19. USB battery pack (student-provided, always-on capable)  
Status: PARTIAL, BENCH-REQUIRED  
Evidence:
- `BOM.txt` item 19 (project procurement baseline)  
Notes:
- No single manufacturer datasheet is enforced because this is student-provided.
- Selection requirement is functional: 5V USB output, >=1A capability, and low-current/always-on behavior compatible with idle windows.
- Requirement closure is bench-only via Test 3.12 (auto-shutoff resilience).

20. Power-on indicator LED (green, generic 5mm)  
Status: PARTIAL, BENCH-REQUIRED  
Evidence:
- `BOM.txt` item 20 (generic indicator part class)  
Notes:
- Generic indicator LED class is acceptable because this branch is not part of the optical sensing path.
- Final closure depends on measured branch current and always-on behavior support in Test 3.13.

21. Power-on indicator resistor (150 Ohm, 1/4W, generic)  
Status: PARTIAL, BENCH-REQUIRED  
Evidence:
- `BOM.txt` item 21 (generic passive class)  
Notes:
- Electrical intent is straightforward and design-targeted to approximately 15-25mA branch current at 5V with a green LED.
- Bench closure required in Test 3.13 with measured current.

### Mechanical/integration materials
22. Elastic headband  
Status: N/A  
Notes:
- Consumer textile item; no electrical datasheet required.

23. EVA foam  
Status: N/A  
Notes:
- Mechanical/optical isolation material; no formal electrical datasheet required.

24. Shielded short cable  
Status: N/A, BENCH-REQUIRED  
Notes:
- Vendor-specific choice; electrical performance validated at assembly/bench level.

25. Opaque adhesive/tape for optical isolation (student-provided class)  
Status: PARTIAL, BENCH-REQUIRED  
Evidence:
- `BOM.txt` item 25 (project procurement baseline)  
Notes:
- Student-provided class item (opaque electrical tape or equivalent); no single mandatory manufacturer datasheet is enforced.
- Closure is bench/assembly-level via leakage controls and dark-test outcomes.

26. Breadboard/perfboard + hookup wire  
Status: N/A  
Notes:
- Prototyping tooling/material set.

27. USB cable  
   Status: N/A  
   Notes:
   - Accessory cable item.

28. Black Rubber Washers
   Status: N/A, BENCH-REQUIRED
   Notes:
   - Mechanical item required as an optical baffle for the 730nm SMD LED. Effectiveness verified in dark test.

## 4) Requirement-Level Closure Impact
Component datasheet compatibility is sufficient for design-level confidence, but does not close bench-dependent requirements.  
Per `validation.txt`, final closure still requires bench execution for:
- ADC address/config readback
- TDM timing capture
- optical safety measurement under final TDM timing (see ISSUE-002 below)
- precision/statistical claim (+/-2% at 95% confidence)
- optical isolation and dark-test performance
- USB battery auto-shutoff resilience on the target power pack
- power-on indicator branch wiring/current verification

### DCN-001 Focused Re-closure Checklist (Required)
- **R-DRV-01 / Test 3.2:** Measure 730nm and 850nm channel currents with final JE2835AFR install; record DMM model, capture setup, and readings.
- **R-OPT-01 / Tests 2.6 + 3.9:** Verify no carrier boards are used, confirm pigtail strain relief + emitter orientation in photos, then run ambient-subtracted dark test and store raw serial log.
- **R-SAFE-01 / Test 3.10:** Measure per-state optical power under final TDM timing; archive raw captures and time-averaged power math.
- **R-PWR-01 / Test 3.12:** Validate no unexpected power cycling during representative idle and active windows on the target USB battery pack.
- **R-PWR-02 / Tests 2.3 + 3.13:** Confirm indicator branch topology at 5V entry node and measure branch current within expected range.
- **Mechanical survivability (DCN-specific):** Perform gentle pigtail flex/pull check, then repeat dark test to confirm no new leak path.

## 5) Cross-Verification Issue Log (2026-03-02)

The following issues were identified during an optics cross-verification pass against the
SFH4253B datasheet (PDF v1.2, 2025-12-01). All issues are also recorded in
`datasheets/optics_validation.txt` and `validation.txt`.
Source provenance for optics claims is documented in `datasheets/optics_source_register.txt`.

ISSUE-001 [MINOR -- CORRECTED]
  File    : datasheets/optics_validation.txt
  Finding : 850nm Vf pre-check band was stated as 1.0-1.8V. V&V plan Test 1.1 (authoritative)
            specifies 1.0-1.9V. Datasheet max VF at 70mA is 1.90V, so 1.9V is correct.
  Fix     : Upper bound updated to 1.9V in optics_validation.txt.
  Impact  : None. Typical VF values (1.55V) are well within both bounds.

ISSUE-002 [RESOLVED]
  Files   : validation.txt (R-SAFE-01, NCR-001), datasheets/optics_validation.txt
  Finding : Legacy optical safety calculation was tied to the old 36 Ohm design case
            (~89mA), which exceeded the project criterion on paper.
  Fix     : R-SAFE-01 verdict changed from OPEN to PASS (conditional) in validation.txt.
            Changed 850nm series resistor from 36 Ohms to 68 Ohms. Current drops to ~47mA,
            peak power to ~36-40mW, and average power to ~9-10mW in 4-state TDM.
  Impact  : Resolved. Human-subject demonstration still requires bench verification.

ISSUE-003 [MINOR -- CORRECTED]
  File    : validation.txt, Section 2 (R-DRV-01 calculation)
  Finding : 850nm current calculation used VF = 1.5V (unspecified). Datasheet gives VF typ
            = 1.60V at 100mA (explicit table entry).
  Fix     : Calculation updated to final drive configuration:
            I = (5.0 - 0.2 - 1.60) / 68 = 47.1mA.
  Impact  : R-DRV-01 verdict unchanged (47.1mA is within 40-50mA band). No design change.

ISSUE-004 [DESIGN CHANGE APPLIED -- DCN-001]
  Files   : BOM.txt, BOM.csv, spec.txt, README.md, validation.txt, hardware-validation.txt
  Finding : Original 730nm LED/carrier pairing was footprint-incompatible and mechanically fragile for probe geometry.
  Fix     : Replaced 730nm LED with JE2835AFR and removed carrier-board dependency; updated assembly to wire-pigtail method.
  Impact  : No topology change to TIP31C + 68 Ohms drive path. Bench re-closure required for R-DRV-01, R-OPT-01, R-SAFE-01.

ISSUE-005 [DESIGN CHANGE APPLIED -- DCN-002]
  Files   : BOM.txt, BOM.csv, spec.txt, README.md, validation.txt, hardware-validation.txt, validation_and_verification_plan.txt
  Finding : Stage 1 TIA compensation capacitor (4.7pF) was mathematically stable but offered limited margin to breadboard parasitics.
  Fix     : Updated compensation value to 10pF and procurement MPN to FG18C0G1H100CNT00.
  Impact  : Estimated phase margin improves from ~47deg to ~60deg with no functional-bandwidth conflict for the design-target ~15 Hz effective per-channel update rate (66.5 ms cycle with required 1ms/state settling delay; 16 Hz remains the conversion-only limit pending bench timing closure).

## 6) Final Component Verification Summary
- VERIFIED: 19 components/classes
- PARTIAL: 3 component/classes
- N/A: 6 non-datasheet materials/accessories
- BENCH-REQUIRED: all performance/safety claims remain bench-gated
- OPEN (blocking): 0 issues

Overall component documentation status: ACCEPTABLE FOR PRE-BENCH DESIGN REVIEW.
OPTICAL SAFETY STATUS: RESOLVED -- bench phase can proceed.
