Ely-S/Cerebro/firmware/cerebral_oximeter/cerebral_oximeter.ino

/*
 * Cerebral Oximeter - NIRS Oxygenation Trend Monitor
 * EE 201 - Biomedical Instrumentation
 *
 * Hardware: Freenove ESP32-WROOM + ADS1115 + MCP6022 + BPW34
 * Revision: 3.2 (DCN-002: TIA Cf = 10pF)
 *
 * Signal chain:
 *   730nm/850nm LEDs (TIP31C drivers, GPIO17/GPIO10)
 *   -> BPW34 photodiode
 *   -> MCP6022 2-stage TIA (100k Rf, 10pF Cf, 48x gain)
 *   -> ADS1115 16-bit ADC (A0, I2C 0x48)
 *   -> Arduino (GPIO21=SDA, GPIO22=SCL)
 *
 * Algorithm:
 *   4-state TDM: AmbientA -> 730nm -> AmbientB -> 850nm
 *   1ms settling delay per state transition
 *   EMA filter: alpha=0.025, N_eff = 1/alpha = 40
 *   30-second automatic baseline averaging
 *   10 Hz serial output (percent change from baseline)
 *
 * Serial Plotter output format (after baseline):
 *   <Red_%change>,<IR_%change>
 *   e.g.: -1.23,0.45
 *
 * Safety: Time-avg emitted power < 10mW per channel (bench-verified).
 *         For educational use only. NOT for clinical diagnosis.
 */

#include <Wire.h>
#include <Adafruit_ADS1X15.h>
#include "algorithm.h"

// --- Pin Definitions ---
const int LED_730_PIN = 17;  // GPIO17: 730nm (Red/Far-Red) LED via TIP31C Q1
const int LED_850_PIN = 16;  // GPIO10: 850nm (IR) LED via TIP31C Q2
const int SDA_PIN     = 21;  // GPIO21: I2C SDA to ADS1115
const int SCL_PIN     = 22;  // GPIO22: I2C SCL to ADS1115

// --- ADC ---
Adafruit_ADS1115 ads;

// --- EMA Filter ---
// alpha = 0.025 => N_eff = 1/alpha = 40 samples effective averaging
// At ~15 Hz TDM rate, N_eff=40 gives ~2.7 seconds of smoothing.
// This rejects noise while tracking the 30s-to-minutes oxygenation
// changes characteristic of POTS.
const float ALPHA = 0.025;
float emaRed = 0.0;
float emaIR  = 0.0;

// --- Baseline Detection ---
// 30 seconds allows EMA to fully settle after power-on transients.
const unsigned long BASELINE_PERIOD_MS = 10000;
unsigned long startTime    = 0;
bool          baselineSet  = false;
float         baselineRed  = 0.0;
float         baselineIR   = 0.0;

// Running sums for baseline averaging (more stable than a single snapshot)
float         baselineSumRed   = 0.0;
float         baselineSumIR    = 0.0;
unsigned long baselineCount    = 0;

// --- Output Timing ---
// TDM runs at ~15 Hz internally; output is decoupled to 10 Hz for
// smooth Serial Plotter display.
const unsigned long OUTPUT_INTERVAL_MS = 1000;
unsigned long lastOutputTime = 0;

// Latest raw ADC reading (updated each TDM cycle) for voltage logging
// GAIN_TWO: +/-2.048V, resolution = 0.0625 mV/count
const float MV_PER_COUNT = 0.0625f;
int16_t lastRawADC = 0;

// ---------------------------------------------------------------------------
// readADC()
//
// Single-shot read of ADS1115 channel A0.
// readADC_SingleEnded() blocks ~15.6ms at 64 SPS until conversion completes,
// satisfying the TDM timing budget without stale-data risk.
//
// Note: The design document (Section 5.4) specifies continuous mode.
// Single-shot is used here for simplicity and identical timing behavior.
// To switch to continuous mode: replace readADC_SingleEnded(0) with
// ads.getLastConversionResults() and add
// ads.startADCReading(ADS1X15_REG_CONFIG_MUX_SINGLE_0, true) in setup().
// ---------------------------------------------------------------------------
int16_t readADC() {
  lastRawADC = ads.readADC_SingleEnded(0);
  return lastRawADC;
}

// ---------------------------------------------------------------------------
// performTDMCycle()
//
// Executes one complete 4-state time-division multiplex cycle:
//   State 1: All LEDs OFF  -> 1ms settle -> Read ADC -> AmbientA
//   State 2: 730nm LED ON  -> 1ms settle -> Read ADC -> Red = active - AmbientA
//   State 3: All LEDs OFF  -> 1ms settle -> Read ADC -> AmbientB
//   State 4: 850nm LED ON  -> 1ms settle -> Read ADC -> IR  = active - AmbientB
//
// Separate ambient reads for each LED channel cancel fast ambient drift
// (e.g., someone walking past, cloud cover changes).
//
// Minimum cycle time: 4 x (1ms settle + 15.6ms conversion) = ~66.5ms (~15 Hz)
// ---------------------------------------------------------------------------
void performTDMCycle(float &redSignal, float &irSignal) {
  int16_t ambient, active;

  // State 1: Ambient A (all LEDs off)
  digitalWrite(LED_730_PIN, LOW);
  digitalWrite(LED_850_PIN, LOW);
  delay(1);
  ambient = readADC();

  // State 2: 730nm ON
  digitalWrite(LED_730_PIN, HIGH);
  delay(1);
  active = readADC();
  digitalWrite(LED_730_PIN, LOW);
  redSignal = ambientSubtract((float)active, (float)ambient);

  // State 3: Ambient B (all LEDs off — explicit for robustness)
  digitalWrite(LED_730_PIN, LOW);
  digitalWrite(LED_850_PIN, LOW);
  delay(1);
  ambient = readADC();

  // State 4: 850nm ON
  digitalWrite(LED_850_PIN, HIGH);
  delay(1);
  active = readADC();
  digitalWrite(LED_850_PIN, LOW);
  irSignal = ambientSubtract((float)active, (float)ambient);
}

// ---------------------------------------------------------------------------
// setup()
// ---------------------------------------------------------------------------
void setup() {
  Serial.begin(9600);
  while (!Serial) { delay(10); }  // Wait for USB serial (remove for battery-only use)

  pinMode(LED_730_PIN, OUTPUT);
  pinMode(LED_850_PIN, OUTPUT);
  digitalWrite(LED_730_PIN, LOW);
  digitalWrite(LED_850_PIN, LOW);

  // ESP32 Wire.begin(SDA, SCL) takes explicit pin arguments — this is the
  // correct API for the Freenove ESP32-WROOM board (not Arduino MbedOS).
  Wire.begin(SDA_PIN, SCL_PIN);
  if (!ads.begin()) {
    Serial.println("ERROR: ADS1115 not found. Check wiring:");
    Serial.println("  - ADS1115 VDD -> 3.3V (NOT 5V)");
    Serial.println("  - ADS1115 GND -> GND");
    Serial.print("  - ADS1115 SDA -> GPIO"); Serial.println(SDA_PIN);
    Serial.print("  - ADS1115 SCL -> GPIO"); Serial.println(SCL_PIN);
    Serial.println("  - ADS1115 ADDR -> GND (address 0x48)");
    while (1) { delay(1000); }  // Halt - ADC required
  }

  // +/-2.048V PGA range: resolution = 2.048*2/65536 = 0.0625mV/count
  // Valid single-ended range at 3.3V supply: 0 to ~26400 counts
  ads.setGain(GAIN_TWO);
  ads.setDataRate(RATE_ADS1115_64SPS);

  startTime = millis();
  Serial.println("Cerebral Oximeter starting...");
  Serial.println("Establishing baseline - keep subject supine and still.");
  Serial.println("(30 seconds)");
}

// ---------------------------------------------------------------------------
// loop()
// ---------------------------------------------------------------------------
void loop() {
  float redSignal, irSignal;

  // Run one complete TDM cycle (~66.5ms)
  performTDMCycle(redSignal, irSignal);

  // Apply EMA filter.
  // First sample seeds the EMA directly to avoid a false "rising signal"
  // artifact. A static bool flag is used instead of checking == 0.0 because
  // a legitimate first sample could be zero (or one channel could be zero
  // while the other is not), which would leave one EMA unseeded.
  // emaSeeded is static: initialized once at power-on, persists for the full
  // program lifetime. It intentionally does NOT reset after baseline — the EMA
  // should never be re-seeded mid-run. Hardware reset or power-cycle reinitializes
  // it automatically. (emaRed/emaIR are global; emaSeeded is local static — both
  // reset together on power-cycle.)
  static bool emaSeeded = false;
  if (!emaSeeded) {
    emaRed    = redSignal;
    emaIR     = irSignal;
    emaSeeded = true;
  } else {
    emaRed = applyEMA(redSignal, emaRed, ALPHA);
    emaIR  = applyEMA(irSignal,  emaIR,  ALPHA);
  }

  // Baseline accumulation: average all EMA-filtered samples over 30 seconds.
  // Both channels share one baselineCount (they are always sampled together).
  // runningMean() is NOT used here because it increments count on each call;
  // calling it twice per cycle with a shared counter would halve both baselines.
  if (!baselineSet) {
    baselineSumRed += emaRed;
    baselineSumIR  += emaIR;
    baselineCount++;
    baselineRed = baselineSumRed / (float)baselineCount;
    baselineIR  = baselineSumIR  / (float)baselineCount;

    if (millis() - startTime >= BASELINE_PERIOD_MS) {
      baselineSet = true;
      Serial.println("Baseline established.");
    }
  }

  // Output at 10 Hz (decoupled from ~15 Hz TDM rate)
  unsigned long now = millis();
  if (now - lastOutputTime >= OUTPUT_INTERVAL_MS) {
    lastOutputTime = now;

    // Log: photodiode voltage, raw signals, EMA, then pct change (or baseline status)
    float mV = lastRawADC * MV_PER_COUNT;
    Serial.print("PD:"); Serial.print(mV, 2); Serial.print("mV");
    Serial.print(" R:");   Serial.print(redSignal, 1);
    Serial.print(" IR:");  Serial.print(irSignal, 1);
    Serial.print(" emaR:"); Serial.print(emaRed, 1);
    Serial.print(" emaIR:"); Serial.print(emaIR, 1);

    if (baselineSet && baselineRed > 0 && baselineIR > 0) {
      float pctRed = calcPctChange(emaRed, baselineRed);
      float pctIR  = calcPctChange(emaIR,  baselineIR);
      Serial.print(" %R:"); Serial.print(pctRed, 2);
      Serial.print(" %IR:"); Serial.println(pctIR, 2);
    } else if (baselineSet) {
      Serial.println(" WARNING: non-positive baseline");
    } else {
      Serial.println(" BASELINE");
    }
  }
}
