Ely-S/Cerebro/(commit log)

2026-03-02 Standardize TIP31C references to ST and refresh BOM docs.
    This updates part-source documentation from onsemi to STMicroelectronics for TIP31C across BOM and validation files, removes the legacy datasheet wrapper, and keeps component verification notes aligned with the latest substituted capacitor selections.
    Made-with: Cursor
    [BOM.csv]
2026-03-02 Migrate 730nm LED to Luminus SST-10-FR-B90-H730; align BOM and cost docs
    - Replace New-Energy Star Board (LST1-01G01-FRD1-00) with Luminus SST-10-FR-B90-H730 bare SMD
    - Add LED carrier boards (Adafruit 1762) to BOM; update assembly for dual SMD carrier mounting
    - Align Component Cost and Estimated Total to $60-97 USD across README, spec.md, spec.txt
    - Restore BOM.csv items 23-27 (opaque tape, carrier boards, breadboard, USB cable, washers)
    - Update validation, optics register, and hardware-validation to new 730nm part and 90° beam
    - Add spec.md; keep spec.txt as canonical spec with updated references
    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
    [BOM.csv]
2026-03-02 switch 730nm LED
    [BOM.csv]
2026-03-02 replace 730nm led
2026-03-03 replace power source and ground topology
    [BOM.csv]
2026-03-03 Transimpedance Amplifier Stability improvement
    [BOM.csv]
2026-03-03 add 1ms delay to led
2026-03-03 switch transistor for availability
    [BOM.csv]
2026-03-06 Update index.html with patient driven science framing and ME/CFS section
2026-03-15 Extract algorithm functions for host-side testing
    - Pull applyEMA, calcPctChange, ambientSubtract, and runningMean from
    cerebral_oximeter.ino into algorithm.h
    - Add firmware/tests/ with C++ unit tests and Makefile
    - Tests run on host without Arduino; validate EMA, pctChange, ambient
    subtraction, running mean, and integration pipeline
    - Enables regression testing for NIRS algorithm changes
    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
2026-03-15 pin remapping and fixing
    [algorithm.h, cerebral_oximeter.ino]
